Yzself/SWIPT-receiver-terminal/PCB/BOM_SWIPT_V3.0_2026-03-11.xlsx

No. | Quantity | Comment | Designator | Footprint | Value | Manufacturer Part | Manufacturer | Supplier Part | Supplier | JLCPCB Price
1 | 1 | 10nF | C1 | C0603 | 10nF | CL10C103JA8NNNC | SAMSUNG(三星) | C307500 | LCSC | 0.16
2 | 2 | 4.7uF | C2,C6 | C0603 | 4.7uF | CL10B475KQ8NQNC | SAMSUNG(三星) | C107368 | LCSC | 0.142
3 | 5 | 100nF | C3,C7,C10,C11,C12 | C0603 | 100nF | CC0603KRX7R9BB104 | YAGEO(国巨) | C14663 | LCSC | 0.0166
4 | 1 | 10uF | C4 | C0805 | 10uF | CL21A106KOQNNNE | SAMSUNG(三星) | C1713 | LCSC | 0.0811
5 | 1 | 0.22F | C5 | CAP-TH_L10.5-W5.0-P5.00-FD | 0.22F | EECS0HD224V | PANASONIC(松下) | C92062 | LCSC | 4.61
6 | 2 | 22uF | C8,C9 | C0805 | 22uF | CL21A226MPQNNNE | SAMSUNG(三星) | C29277 | LCSC | 0.116
7 | 1 | 2.2nF | C13 | C0805 | 2.2nF | MSASQ219SB5222MTNA01 | TAIYO YUDEN(太诱) | C5806795 | LCSC | 0.667
8 | 1 | 47nF | C14 | C0805 | 47nF | C0603X5R1A473M030BC | TDK | C20529216 | LCSC | 1.752
9 | 2 | 1N5819WS | D1,D2 | SOD-323_L1.8-W1.3-LS2.5-RD |  | 1N5819WS | Hottech(合科泰) | C191023 | LCSC | 0.0551
10 | 2 | 排针 1*4P | H1,H2 | HDR-TH_4P-P2.54-V-M |  | 排针 1*4P |  | C59481 | LCSC | 0.0762
11 | 1 | 2.54-1*3P针 | H3 | HDR-TH_3P-P2.54-V-M-1 |  | 2.54-1*3P针 | BOOMELE(博穆精密) | C49257 | LCSC | 0.123
12 | 3 | KEY | KEY1,KEY2,KEY3 | SW-SMD_L6.0-W3.7-LS8.0 |  | KEY |  | C9900023212 | LCSC | 0.243
13 | 1 | 22uH | L1 | IND-SMD_L4.0-W4.0_LQH44PN2R2MP0L | 22uH | SWPA4018S220MT | Sunlord(顺络) | C83443 | LCSC | 0.363
14 | 1 | 10uH | L2 | IND-SMD_L4.0-W4.0 | 10uH | SWPA4018S100MT | Sunlord(顺络) | C83442 | LCSC | 0.36
15 | 1 | MC096GW | OLED1 | OLED-TH_4P-L27.8-W27.3_MC096GW |  | MC096GW |  | C9900209498 | LCSC
16 | 7 | 2.54mm 1*2P | P1,P2,P3,P4,P5,P6,P7 | HDR-TH_2P-P2.54-V-M |  | 2.54mm 1*2P |  | C36717 | LCSC | 0.0372
17 | 1 | DS18B20 | P8 | HDR-TH_3P-P2.54-V-F |  | DS18B20 | BOOMELE(博穆精密) | C146243 | LCSC | 0.415
18 | 1 | 5.1MΩ | R1 | R0603 | 5.1MΩ | MCT06030C5104FP500 | VISHAY(威世) | C7225836 | LCSC | 0.294
19 | 1 | 6.8MΩ | R2 | R0603 | 6.8MΩ | CR0603JA0685G | LIZ(丽智电子) | C3037235 | LCSC | 0.006
20 | 1 | 500kΩ | R3 | RES-ADJ-TH_3296W | 500kΩ | 3296W-504-LF | BAOTER(宝特) | C48641852 | LCSC | 0.669
21 | 1 | 100kΩ | R4 | R0805 | 100kΩ | TRR10EZPJ104 | ROHM(罗姆) | C6290028 | LCSC | 0.362
22 | 1 | 20kΩ | R5 | R0805 | 20kΩ | MMV05F20K0E | Ohmite | C7303912 | LCSC | 0.681
23 | 1 | 4.7kΩ | R6 | R1206 | 4.7kΩ | SR1206FR-7W4K7L | YAGEO(国巨) | C873960 | LCSC | 0.253
24 | 1 | 1.01kΩ | R7 | R0603 | 1.01kΩ | RT0603BRD071K01L | YAGEO(国巨) | C861188 | LCSC | 0.16
25 | 1 | 4.7MΩ | Rok1 | R0603 | 4.7MΩ | RCA034M7JLF | HKR(香港电阻) | C22356598 | LCSC | 0.0045
26 | 1 | 5.1MΩ | Rok2 | R0603 | 5.1MΩ | CRCW06031M50FKEA | VISHAY(威世) |  | LCSC
27 | 1 | 3MΩ | Rok3 | R0603 | 3MΩ | AC0603FR-076M65L | YAGEO(国巨) |  | LCSC
28 | 1 | 5.1MΩ | Rov1 | R0603 | 5.1MΩ | RC0603FR-075M62L | YAGEO(国巨) |  | LCSC
29 | 1 | 6.8MΩ | Rov2 | R0603 | 6.8MΩ | RC0603FR-077M32L | YAGEO(国巨) |  | LCSC
30 | 1 | LCKFB-DKX-STM32F103C8T6 | U1 | CONN-TH_L53.3-W22.9_STM32F103C8T6-CARD |  | LCKFB-DKX-STM32F103C8T6 | 立创开发板 | C22396880 | LCSC | 11.46
31 | 1 | BQ25505RGRT | U2 | VQFN-20_L3.5-W3.5-P0.50-BL-EP2.0 |  | BQ25505RGRT | TI(德州仪器) | C2876730 | LCSC | 18.41
32 | 1 | TPS62736RGYR | U3 | VQFN-14_L3.5-W3.5-P0.50-TL-EP |  | TPS62736RGYR | TI(德州仪器) | C2071494 | LCSC | 21.57
33 | 1 | DX-BT24-T | U5 | BULETM-SMD_DX-BT24-T |  | DX-BT24-T |  | C2895194 | LCSC | 0.004
34 | 1 | TLV333IDBVR | U6 | SOT-23-5_L2.9-W1.6-P0.95-LS2.8-BL |  | TLV333IDBVR | TI(德州仪器) | C473369 | LCSC | 1.532
35 | 1 | CR2032 BS-8 | U7 | BAT-SMD_CR2032-BS-8 |  | CR2032 BS-8 |  | C9900110766 | LCSC | 0.243
