Yzself/SWIPT-receiver-terminal/STM32F103/yz_freertos_vscode/Core/Inc/main.h

#define AUX_Pin GPIO_PIN_12
#define AUX_GPIO_Port GPIOB
#define M2_Pin GPIO_PIN_13
#define M2_GPIO_Port GPIOB
#define M1_Pin GPIO_PIN_14
#define M1_GPIO_Port GPIOB
#define M0_Pin GPIO_PIN_15
#define M0_GPIO_Port GPIOB
