Yzself/SWIPT-receiver-terminal/STM32F103/yz_freertos_vscode/BSP/Uart_Printf.h

#ifndef __UART_PRINTF_H__
#define __UART_PRINTF_H__

/**
 * @file    Uart_Printf.h
 * @brief   UART2 printf redirection interface
 * @author  YuZhang Lin
 * @date    2026-06-26
 */


#ifdef __cplusplus
extern "C" {
#endif

void Uart_Printf_Init(void);

#ifdef __cplusplus
}
#endif

#endif /* __UART_PRINTF_H__ */
