Yzself/SWIPT-receiver-terminal/(commit log)

2026-05-06 SWIPT接收终端 — 初始提交
    包含 PCB Gerber 文件 (V1.0~V9.0) 和 STM32F103 FreeRTOS 固件工程。
    [BOM_SWIPT_V3.0_2026-03-11.xlsx]
2026-05-06 添加项目 README 文档
    涵盖硬件平台、FreeRTOS 软件架构、信号处理链、波束扫描模式及蓝牙指令说明。
2026-05-06 重写 README：基于 yz_freertos_vscode 工程
    修正温湿度传感器为 AHT20，补充 CMake 构建说明、波束扫描参数、
    蓝牙通信协议、解调消息分发和完整的目录结构。
2026-05-06 README 添加 emoji 美化
    为各章节和模块添加对应图标，提升文档可读性。
2026-05-06 添加 CLAUDE.md：项目架构与开发指南
    供 Claude Code 等 AI 辅助工具理解项目结构和开发约定。
2026-05-06 修正功耗管理描述：DIM 保持采样、DEEP_SLEEP 射频唤醒
    - DIM 模式下仅关闭 OLED，ADC 采样和蓝牙持续工作
    - DEEP_SLEEP 使用 STANDBY 模式，PA0 WKUP 引脚检测射频波自主唤醒
    - 唤醒后系统复位，重新初始化进入 ACTIVE
2026-06-25 蓝牙驱动替换为 SubGHz_CC1310（E70-433T），新增 UART2 printf 重定向
    - BSP: Bluetooth.c/h 重命名为 SubGHz_CC1310.c/h，完整重写为 E70-433T CC1310 驱动
    - 支持 8 种工作模式（透传/分包/AT配置/WOR/休眠），按 M2-M1-M0 二进制编码
    - 每次发送前检查 AUX 引脚，切模式前后等 AUX 上升沿 + 2ms
    - 队列注册 API（CC1310_Queue_Register），去除 PA11 电源管理
    - 修复 RX 回调先入队后清零导致 consumer 读到空数据的 bug
    - BSP: 新增 Uart_Printf.c/h，重定向 _write 到 USART2，带 FreeRTOS 互斥锁
    - Core: CubeMX 配置 USART2 + M0/M1/M2/AUX 引脚（PB15/PB14/PB13/PB12）
    - User: PowerManager 修复编码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
    [PowerManager.c, PowerManager.h, SubGHz_CC1310.c, SubGHz_CC1310.h, Uart_Printf.c, Uart_Printf.h]
2026-06-26 所有驱动文件添加署名头：@file/@brief/@author/@date
    BSP/ 和 User/ 全部 22 个 .c/.h 文件统一添加
    @file / @brief / @author YuZhang Lin / @date 2026-06-26
2026-06-26 修复 RX 缓冲区竞争、新增 POWER_MANAGER_ENABLE 调试开关、整理乱码
    - SubGHz_CC1310: 移除 RX 回调中的 memset 防止 consumer 读到空数据
    - Global_Define: 新增 POWER_MANAGER_ENABLE 宏 (0=关闭低功耗)，注释改为英文
    - PowerManager: 关闭时 osThreadSuspend 挂起自身，修复超时常量，注释改为英文
    - freertos: 队列重命名 blueToothQueue → subMessageQueue，CC1310_Open 移出 StartDefaultTask
    [Global_Define.h, PowerManager.c, PowerManager.h, SubGHz_CC1310.c]
2026-06-26 添加 E70-433T CC1310 模块用户手册 v1.1
2026-06-26 POWER_MANAGER_ENABLE=0 改为编译期裁掉电源管理状态机
    原 osThreadSuspend(NULL) 方案不生效，改为 #if 将整个状态机循环
    替换为空转 osDelay，Prepare_For_Sleep/STANDBY 不会被编译进 elf。
    StartDefaultTask 新增 OLED 显示 POWER_MANAGER_ENABLE 状态。
2026-06-29 CubeMX 升级：FW V1.8.7 + HAL/FreeRTOS SDK 更新
2026-06-29 添加 CubeMX 临时文件到 .gitignore
2026-07-01 messageTask 新增 CC1310_SendPrintf 蓝牙调试输出
