Yzself/SWIPT-receiver-terminal/(notices)

Notices in the files:
STM32F103/yz_freertos_vscode/Core/Inc/main.h:
Copyright (c) 2025 STMicroelectronics.
All rights reserved.
This software is licensed under terms that can be found in the LICENSE file
